Nold360/n64_stick_converter/README.md

# N64 Stick Converter
Fork/Mirror of the "N64 Stick Converter PCB" by Jakob Schäfer
This Fork has been created for preservation and better accessability. 

Official Release: https://circuit-board.de/forum/index.php/Thread/16779-N64-Stick-Converter-PCB-v3/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
