Nold360/n64_stick_converter/PCB/README.txt

PCB thickness:	1.2 mm
surface finish:	HASL (cheaper) or ENIG
