Nold360/n64_stick_converter/schematic.pdf

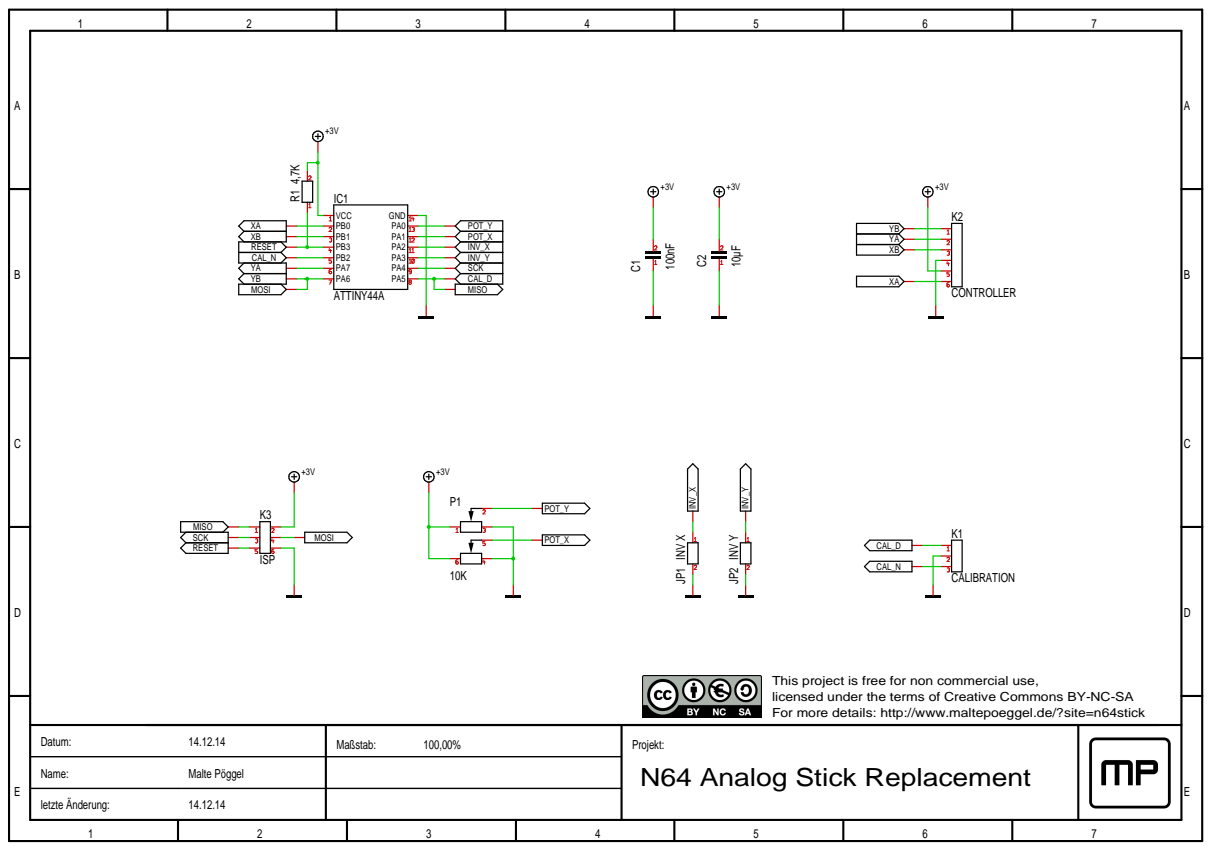
[picture p25: page 1]
MOSI; MISO; CONTROLLER; SCK RESET; ISP; POT_X; POT_Y; INV_X; INV_Y; CAL_N; CAL_D; SCK; RESET; POT_Y POT_X; CALIBRATION; INV Y JP2; INV X JP1; GND; VCC; ATTINY44A

This project is free for non commercial use,
licensed under the terms of Creative Commons BY-NC-SA
For more details: http://www.maltepoeggel.de/?site=n64stick

Datum: 14.12.14 | Maßstab: 100,00% | Projekt: N64 Analog Stick Replacement

Name: Malte Pöggel

letzte Änderung: 14.12.14
