Nold360/n64_stick_converter/(commit log)

2017-08-02 Create Fork of the "N64 Stick Converter PCB" by Jakob Schäfer
2017-08-02 Add: PCB Files
    [N64_STICK_CONVERTER_PCB_V3.GBL, N64_STICK_CONVERTER_PCB_V3.GBO, N64_STICK_CONVERTER_PCB_V3.GBS, N64_STICK_CONVERTER_PCB_V3.GTL, N64_STICK_CONVERTER_PCB_V3.GTO, N64_STICK_CONVERTER_PCB_V3.GTS]
2017-08-02 Add: PCB.pdf
2017-12-08 Add: Schematic
